oshdev-pdam/oshw-pdambekasi/VisualisasiDesain/VisualisasiWeb4.png

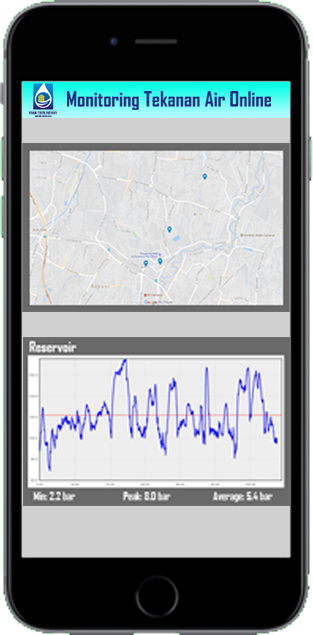
VisualisasiDesain/VisualisasiWeb4.png
