oshdev-pdam/oshw-pdambekasi/VisualisasiDesain/Visualisasi Device 5.png

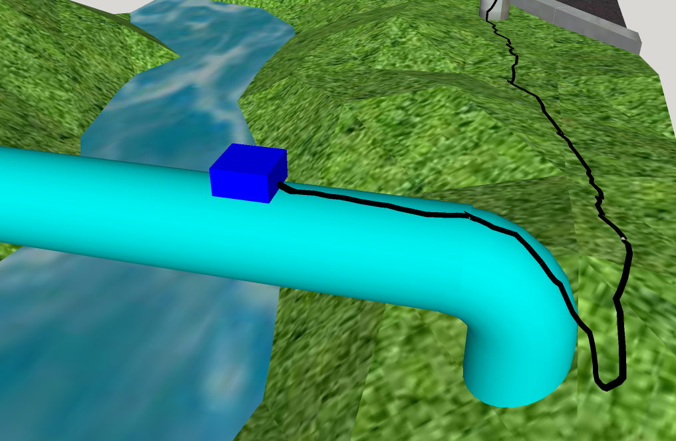
VisualisasiDesain/Visualisasi Device 5.png
