oshdev-pdam/oshw-pdambekasi/README.md

# oshw-pdambekasi

Repositori rintisan untuk OSH Development sensor tekanan air untuk PDAM Kota Bekasi
