oshdev-pdam/oshw-pdambekasi/Data Analysis/Unit One 24 Hours Graph.png

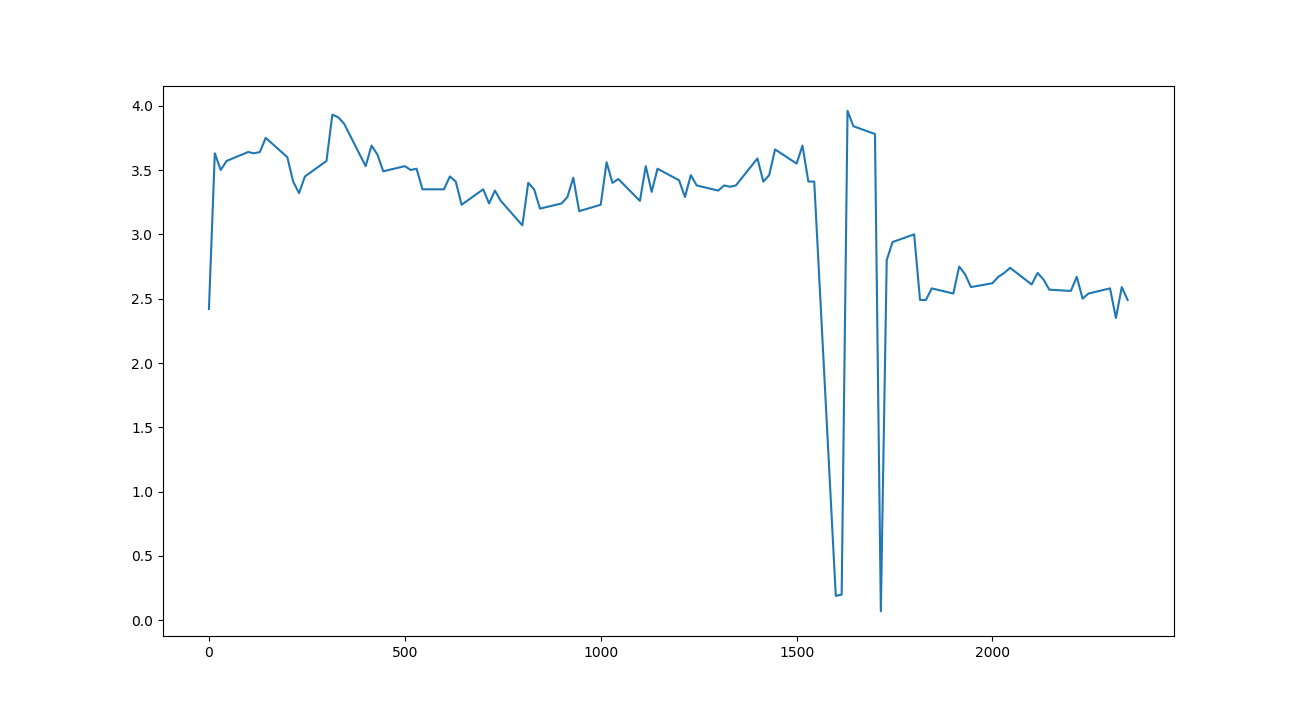
Data Analysis/Unit One 24 Hours Graph.png
