oshdev-pdam/oshw-pdambekasi/Data Analysis/Unit Three 24 Hours Graph.png

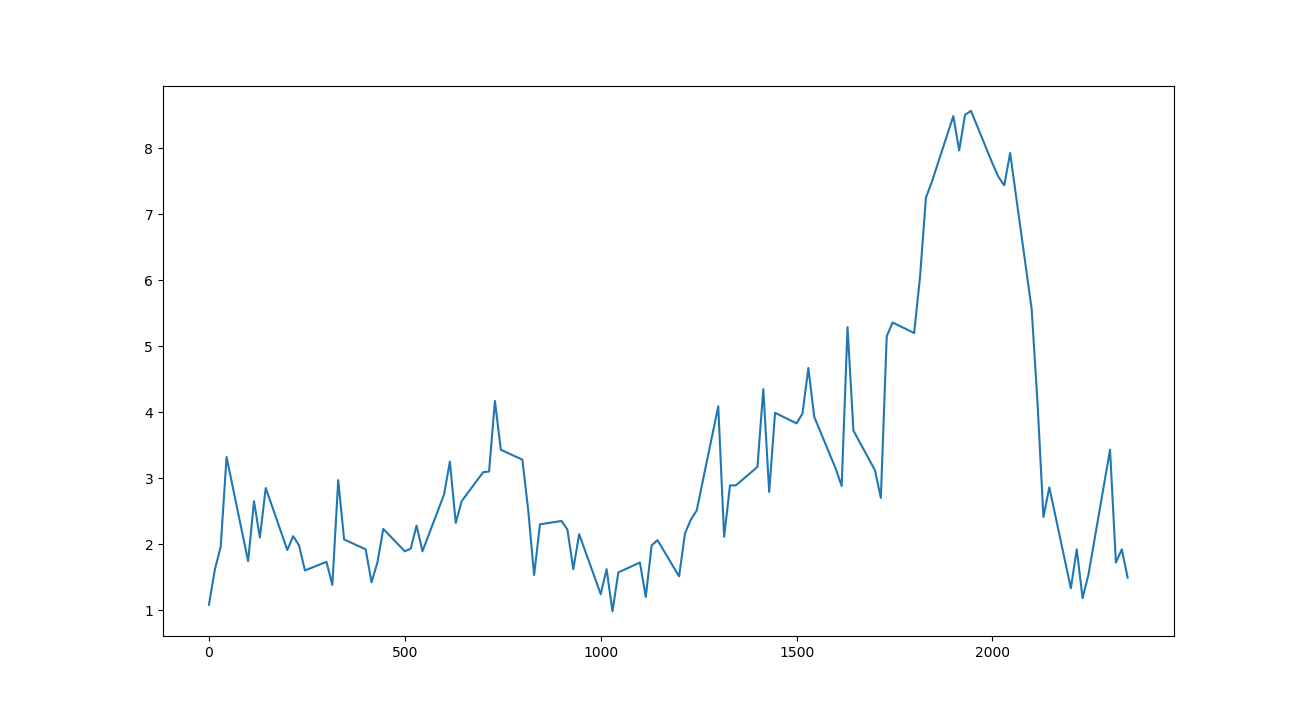
Data Analysis/Unit Three 24 Hours Graph.png
