oshdev-pdam/oshw-pdambekasi/Data Analysis/Unit Two 24 Hours Graph.png

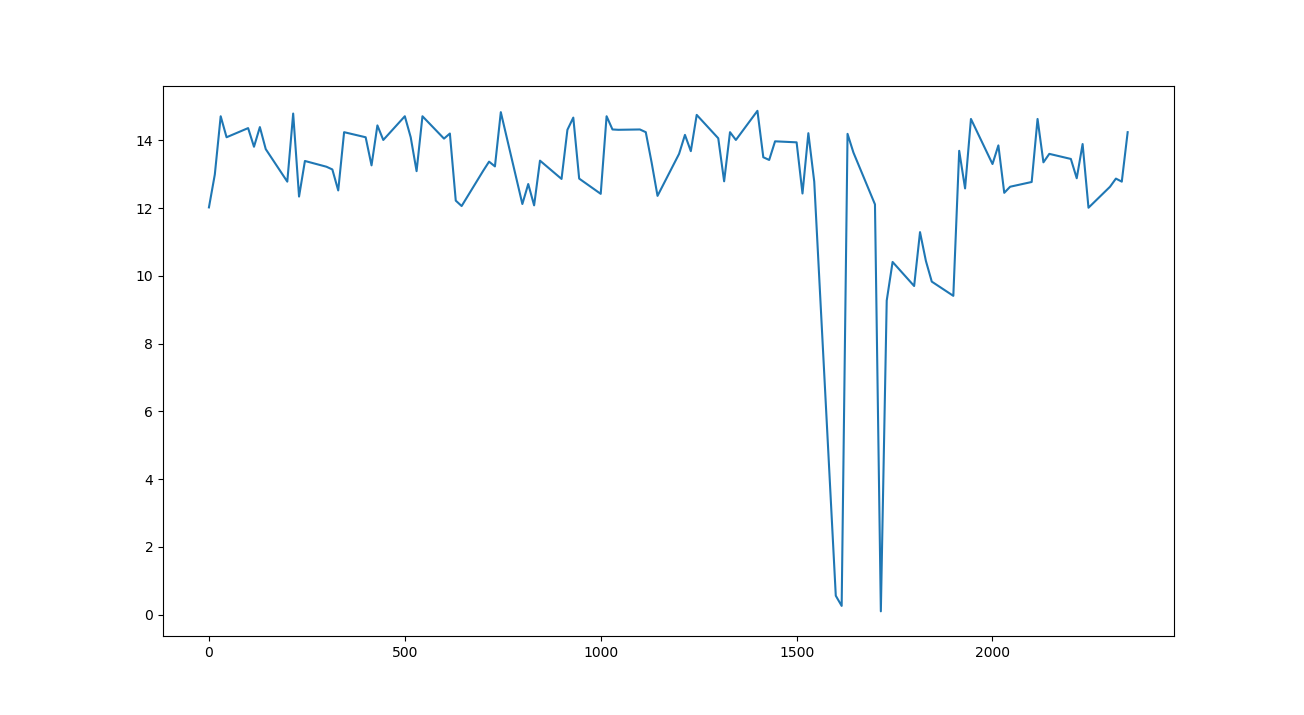
Data Analysis/Unit Two 24 Hours Graph.png
