oshdev-pdam/oshw-pdambekasi/ProductWireframe/ProductUserFlow.jpg

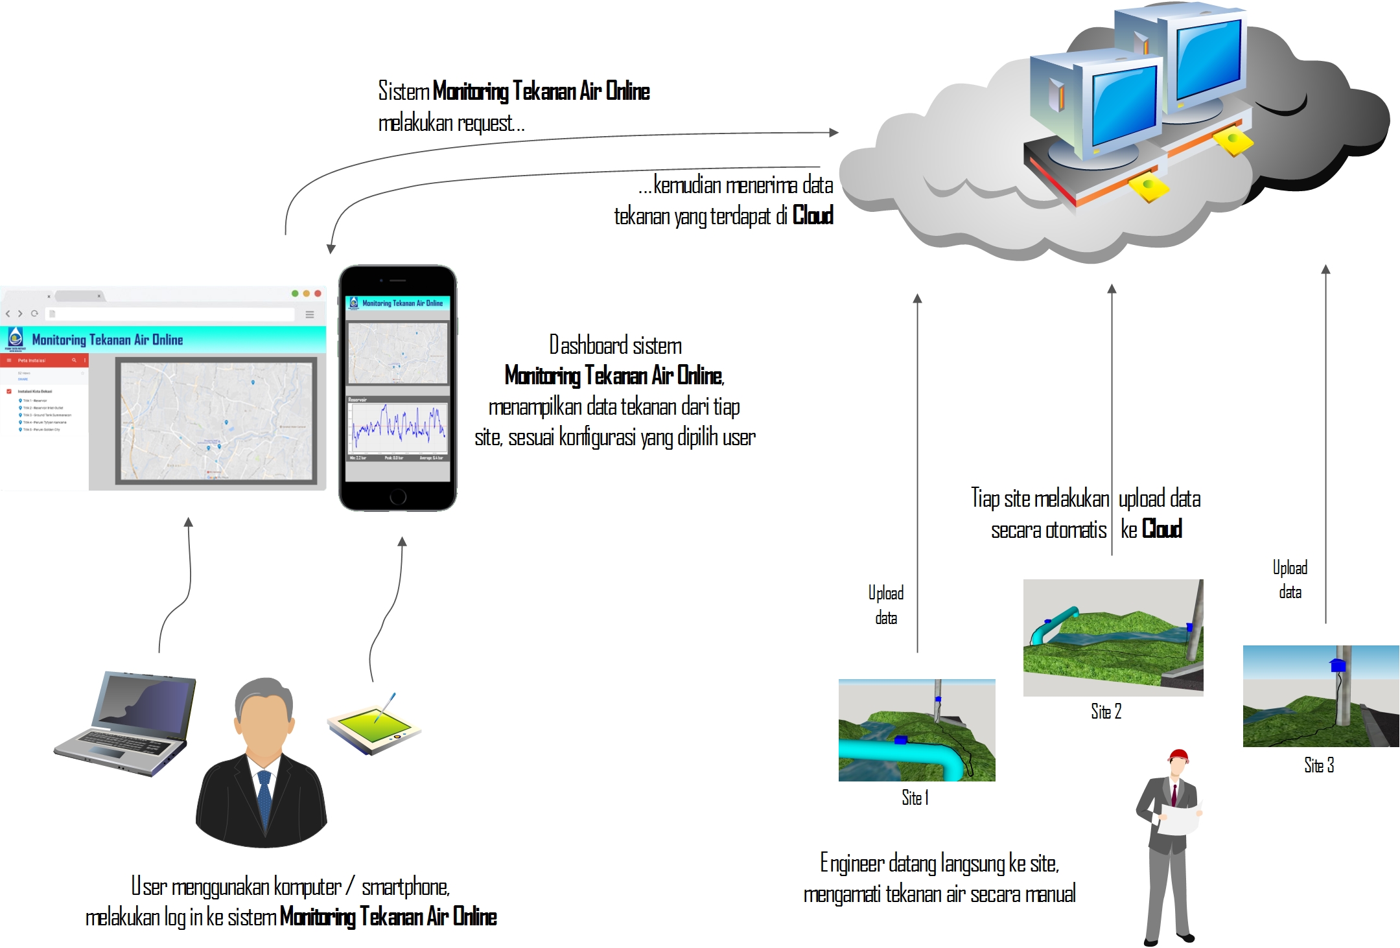
ProductWireframe/ProductUserFlow.jpg
