oshdev-pdam/oshw-pdambekasi/VisualisasiDesain/Visualisasi Device 3.png

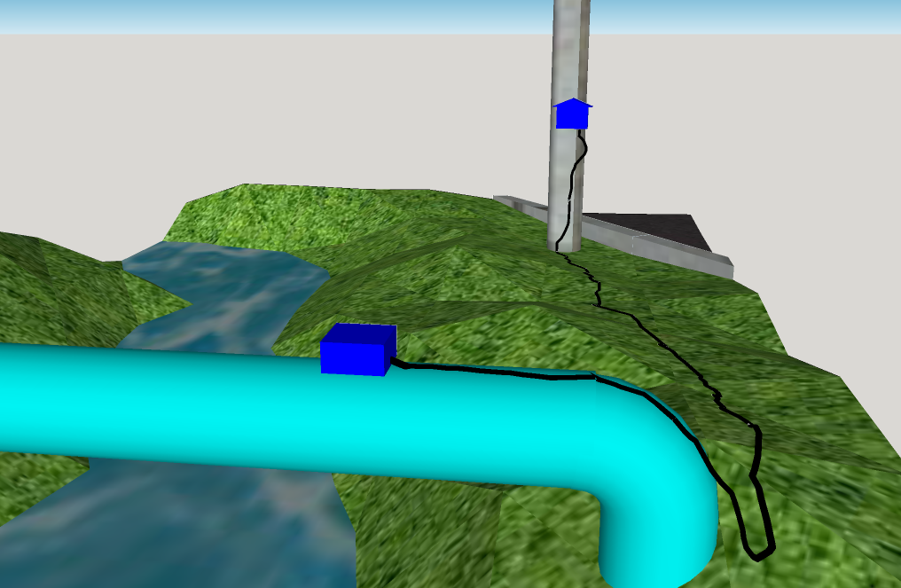
VisualisasiDesain/Visualisasi Device 3.png
