oshdev-pdam/oshw-pdambekasi/Bill Of Maaterial.xlsx

Sheet: Sheet1
 | Bill Of Materials
dapet di: | Nama Komponen BEST | Nama Komponen budget | Justifikasi Pemakaian | Harga Satuan BEST | Harga Satuan budget | Quantity | Harga Total BEST | Harga Total budget
www.tokopedia.com/akhishop/adafruit-feather-m0-adalogger | Adafruit Feather M0 Adalogger |  | Sebagai Master & Slave, plus logging ke kartu MicroSD | Rp 305000.00 | Rp 305000.00 | 1 | Rp 305000.00 | Rp 305000.00
www.tokopedia.com/rajacell/ds3231-i2c-rtc-module-for-arduino-real-time-clock-iic-module | DS3231 I2C RTC Module |  | Modul Real-Time Clock untuk logging dan fungsi wakeup | Rp 24500.00 | Rp 24500.00 | 1 | Rp 24500.00 | Rp 24500.00
www.tokopedia.com/tokoduino/max485-ttl-to-rs485-to-ttl-rs-485-serial-module-converter-arduino | MAX485 TTL to RS485 Module |  | Untuk melakukan transmisi data antara Master dan Slave | Rp 20000.00 | Rp 20000.00 | 2 | Rp 40000.00 | Rp 40000.00
www.tokopedia.com/diggyshop/pressure-transmitter-dc-5v-0-174-psi-12mpa-pressure-sensor | Pressure Transmitter DC 5V 0-1.2MPa (0-10 bar) |  | Sensor tekanan air | Rp 250000.00 | Rp 250000.00 | 1 | Rp 250000.00 | Rp 250000.00
www.tokopedia.com/akhishop/adafruit-fona-808-mini-cellular-gsm-gps-breakout | Adafruit FONA SIM808 |  | Modul GSM dengan performa teruji | Rp 750000.00 |  | 1 | Rp 750000.00
www.tokopedia.com/dielectronics/sim900-sim900a-v40-ver4-v4-module-gsm-gprs-board-with-antena |  | SIM900 GSM Module |  |  | Rp 220000.00 | 1 |  | Rp 220000.00
www.indorcstore.com/id/other-lipo/895-turnigy-3000mah-3s-30c-lipo-pack.html | Turnigy Li-Po 3 Cell 3000mAh |  | Baterai backup saat terjadi pemadaman | Rp 500000.00 |  | 1 | Rp 500000.00
www.indorcstore.com/id/other-lipo/949-turnigy-1000mah-3s-20c-lipo-pack.html |  | Turnigy Li-Po 3 Cell 1000mAh |  |  | Rp 190000.00 | 1 |  | Rp 190000.00
www.tokopedia.com/buayainstrument/turnigy-5a-8-40v-sbec-ubec-for-lipo | Turnigy 5A UBEC SBEC for Li-Po |  | Menurunkan tegangan untuk digunakan Master dan Slave | Rp 115000.00 |  | 2 | Rp 230000.00
www.tokopedia.com/buayainstrument/turnigy-3a-ubec-with-low-voltage-buzzer |  | Turnigy 3A UBEC for Li-Po |  |  | Rp 85000.00 | 2 |  | Rp 170000.00
www.jababekaelektrik.com/collections/electric-enclosure/products/tibox-steel-enclosure-ip-65 | Tibox Steel IP65 250Hx200Wx150D |  | Sebagai casing bagi Master | Rp 306000.00 |  | 1 | Rp 306000.00
www.tokopedia.com/mrdelectronics/junction-box-panel-box-250x200x110mm-ip66 |  | Junction Box IP66 250Hx200Wx110D |  |  | Rp 95000.00 | 1 |  | Rp 95000.00
www.jababekaelektrik.com/collections/electric-enclosure/products/tibox-ip66-abs-enclosure | Tibox IP66 ABS 110Hx80Wx70D |  | Sebagai casing bagi Slave | Rp 49500.00 |  | 1 | Rp 49500.00
www.tokopedia.com/mrdelectronics/junction-box-panel-box-250x200x110mm-ip66 |  | Junction Box IP66 80Hx80Wx40D |  |  | Rp 19000.00 | 1 |  | Rp 19000.00
 | Power switcher module (PLN ke 9V pake adapter [mirip charger HP], tambah rangkaian switcher yang belom ketemu) |  | Memungkinkan penggunaan sumber listrik PLN (utama) dan baterai (cadangan) secara bersamaan | Rp 200000.00 | Rp 200000.00 | 1 | Rp 200000.00 | Rp 200000.00
 | SIM Card dan biaya pulsa modul |  | Untuk transmisi data dari Master ke Server | Rp 100000.00 | Rp 100000.00 | 1 | Rp 100000.00 | Rp 100000.00
 | Komponen lainnya |  | Kabel, sealant, bikin PCB, cable tie, dan lainnya | Rp 200000.00 | Rp 200000.00 | 1 | Rp 200000.00 | Rp 200000.00
 |  |  |  |  | TOTAL |  | Rp 2955000.00 | Rp 1813500.00

Sheet: Budget
 | Nama Komponen DEVICE GSM | Justifikasi Pemakaian | Harga Satuan | Jumlah | Harga Total | Source
lokal | SIM900 GSM Module | Modul GSM dengan performa teruji | Rp 220000.00 | 1 | Rp 220000.00 | https://www.tokopedia.com/dielectronics/sim900-sim900a-v40-ver4-v4-module-gsm-gprs-board-with-antena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
lokal | SIM Card dan biaya pulsa modul | Untuk transmisi data dari Master ke Server | Rp 100000.00 | 1 | Rp 100000.00
adafruit | Adafruit Feather M0 Adalogger | Sebagai Master & Slave, plus logging ke kartu MicroSD | Rp 305000.00 | 1 | Rp 305000.00 | https://www.adafruit.com/product/2796
lokal | DS3231 I2C RTC Module | Modul Real-Time Clock untuk logging dan fungsi wakeup | Rp 24500.00 | 1 | Rp 24500.00 | https://www.tokopedia.com/pitoserba/ds3231-i2c-rtc-module-modul-jam-arduino-raspberry-pi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
lokal | MAX485 TTL to RS485 Module | Untuk melakukan transmisi data antara Master dan Slave | Rp 20000.00 | 2 | Rp 40000.00 | https://www.tokopedia.com/tokoduino/max485-ttl-to-rs485-to-ttl-rs-485-serial-module-converter-arduino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
lokal | Pressure Transmitter DC 5V 0-1.2MPa (0-10 bar) | Sensor tekanan air | Rp 250000.00 | 1 | Rp 250000.00 | https://www.tokopedia.com/diggyshop/pressure-transmitter-dc-5v-0-174-psi-12mpa-pressure-sensor?src=topads
lokal | Turnigy Li-Po 3 Cell 1000mAh | Baterai backup saat terjadi pemadaman | Rp 190000.00 | 1 | Rp 190000.00 | https://www.tokopedia.com/nanomarket/baterai-lipo-turnigy-1000mah-3s-20c-lipo-pack
lokal | Turnigy 3A UBEC for Li-Po | Menurunkan tegangan untuk digunakan Master dan Slave | Rp 85000.00 | 2 | Rp 170000.00 | https://www.tokopedia.com/andreas-ega/ubec-turnigy-3a-5-6v-buzzer
lokal | Junction Box IP66 250Hx200Wx110D | Sebagai casing bagi Master | Rp 95000.00 | 1 | Rp 95000.00 | https://www.tokopedia.com/trijayatehnik/junction-box-uk200x150x100-ip66
lokal | Junction Box IP66 80Hx80Wx40D | Sebagai casing bagi Slave | Rp 19000.00 | 1 | Rp 19000.00 | https://www.tokopedia.com/trijayatehnik/junction-box-uk125x125x75-ip66
lokal | Power switcher module | Memungkinkan penggunaan sumber listrik PLN (utama) dan baterai (cadangan) secara bersamaan | Rp 200000.00 | 1 | Rp 200000.00 | https://www.tokopedia.com/dielectronics/sim900-sim900a-v40-ver4-v4-module-gsm-gprs-board-with-antena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
 | Komponen lainnya | Kabel, sealant, bikin PCB, cable tie, dan lainnya | Rp 200000.00 | 1 | Rp 200000.00
 |  |  | TOTAL |  | Rp 1813500.00
 | Nama Komponen DEVICE LoRa | Justifikasi Pemakaian | Harga Satuan | Jumlah | Harga Total
www.tokopedia.com/raspberrypi/lora-bee-915-mhz-dragino | Dragino LoRa Bee 915MHz | Modul LoRa untuk transmisi data | Rp 250000.00 | 1 | Rp 250000.00 | www.tokopedia.com/raspberrypi/lora-bee-915-mhz-dragino
lokal | Adafruit Feather M0 Adalogger | Sebagai Master & Slave, plus logging ke kartu MicroSD | Rp 305000.00 | 1 | Rp 305000.00 | https://www.adafruit.com/product/2796
lokal | DS3231 I2C RTC Module | Modul Real-Time Clock untuk logging dan fungsi wakeup | Rp 24500.00 | 1 | Rp 24500.00 | https://www.tokopedia.com/pitoserba/ds3231-i2c-rtc-module-modul-jam-arduino-raspberry-pi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
lokal | MAX485 TTL to RS485 Module | Untuk melakukan transmisi data antara Master dan Slave | Rp 20000.00 | 2 | Rp 40000.00 | https://www.tokopedia.com/tokoduino/max485-ttl-to-rs485-to-ttl-rs-485-serial-module-converter-arduino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
lokal | Pressure Transmitter DC 5V 0-1.2MPa (0-10 bar) | Sensor tekanan air | Rp 250000.00 | 1 | Rp 250000.00 | https://www.tokopedia.com/diggyshop/pressure-transmitter-dc-5v-0-174-psi-12mpa-pressure-sensor?src=topads
lokal | Turnigy Li-Po 3 Cell 1000mAh | Baterai backup saat terjadi pemadaman | Rp 190000.00 | 1 | Rp 190000.00 | https://www.tokopedia.com/nanomarket/baterai-lipo-turnigy-1000mah-3s-20c-lipo-pack
lokal | Turnigy 3A UBEC for Li-Po | Menurunkan tegangan untuk digunakan Master dan Slave | Rp 85000.00 | 2 | Rp 170000.00 | https://www.tokopedia.com/andreas-ega/ubec-turnigy-3a-5-6v-buzzer
lokal | Junction Box IP66 250Hx200Wx110D | Sebagai casing bagi Master | Rp 95000.00 | 1 | Rp 95000.00 | https://www.tokopedia.com/trijayatehnik/junction-box-uk200x150x100-ip66
lokal | Junction Box IP66 80Hx80Wx40D | Sebagai casing bagi Slave | Rp 19000.00 | 1 | Rp 19000.00 | https://www.tokopedia.com/trijayatehnik/junction-box-uk125x125x75-ip66
lokal | Power switcher module | Memungkinkan penggunaan sumber listrik PLN (utama) dan baterai (cadangan) secara bersamaan | Rp 200000.00 | 1 | Rp 200000.00 | https://www.tokopedia.com/dielectronics/sim900-sim900a-v40-ver4-v4-module-gsm-gprs-board-with-antena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
lokal | Komponen lainnya | Kabel, sealant, bikin PCB, cable tie, dan lainnya | Rp 200000.00 | 1 | Rp 200000.00
 |  |  | TOTAL |  | Rp 1743500.00
