oshdev-pdam/oshw-pdambekasi/BOM Completion - Unit #1.xlsx

LIST BELANJA UNIT #1
Nama Komponen | Harga Satuan | Jumlah | Harga Total | Website Vendor | Link Belanja | Confirmed Tersedia
SIM900 GSM Module | Rp 220000 | 1 | Rp 220000 | Toped | http://bit.ly/2xSdEz1
SIM Card dan biaya pulsa modul | Rp 100000 | 1 | Rp 100000 | Lokal
Adafruit Feather M0 Adalogger | Rp 305000 | 1 | Rp 305000 | Bukalapak | http://bit.ly/2yTtBFa
DS3231 I2C RTC Module | Rp 24500 | 1 | Rp 24500 | Toped | http://bit.ly/2l1Ddrs
MAX485 TTL to RS485 Module | Rp 20000 | 2 | Rp 40000 | Toped | http://bit.ly/2inzYtu
Pressure Transmitter DC 5V 0-1.2MPa (0-10 bar) | Rp 250000 | 1 | Rp 250000 | Toped | http://bit.ly/2ytzSqx
Turnigy Li-Po 3 Cell 1000mAh | Rp 190000 | 1 | Rp 190000 | Toped | http://bit.ly/2gnOyNi
Turnigy 3A UBEC for Li-Po | Rp 85000 | 2 | Rp 170000 | Toped | http://bit.ly/2ionUIg
Junction Box IP66 250Hx200Wx110D | Rp 95000 | 1 | Rp 95000 | Toped | http://bit.ly/2guRLOD
Junction Box IP66 80Hx80Wx40D | Rp 19000 | 1 | Rp 19000 | Toped | http://bit.ly/2xSxSbZ
Power switcher module | Rp 200000 | 1 | Rp 200000 | Toped | http://bit.ly/2xSdEz1
Komponen lainnya | Rp 200000 | 1 | Rp 200000 | Glodok
 | TOTAL |  | Rp 1813500
Ready Stock
Ready Sebagian
Tidak Ready/Inden/Harus Import
