oshdev-pdam/oshw-pdambekasi/KiCAD/Latest/OSH DEV-SchDoc.pdf

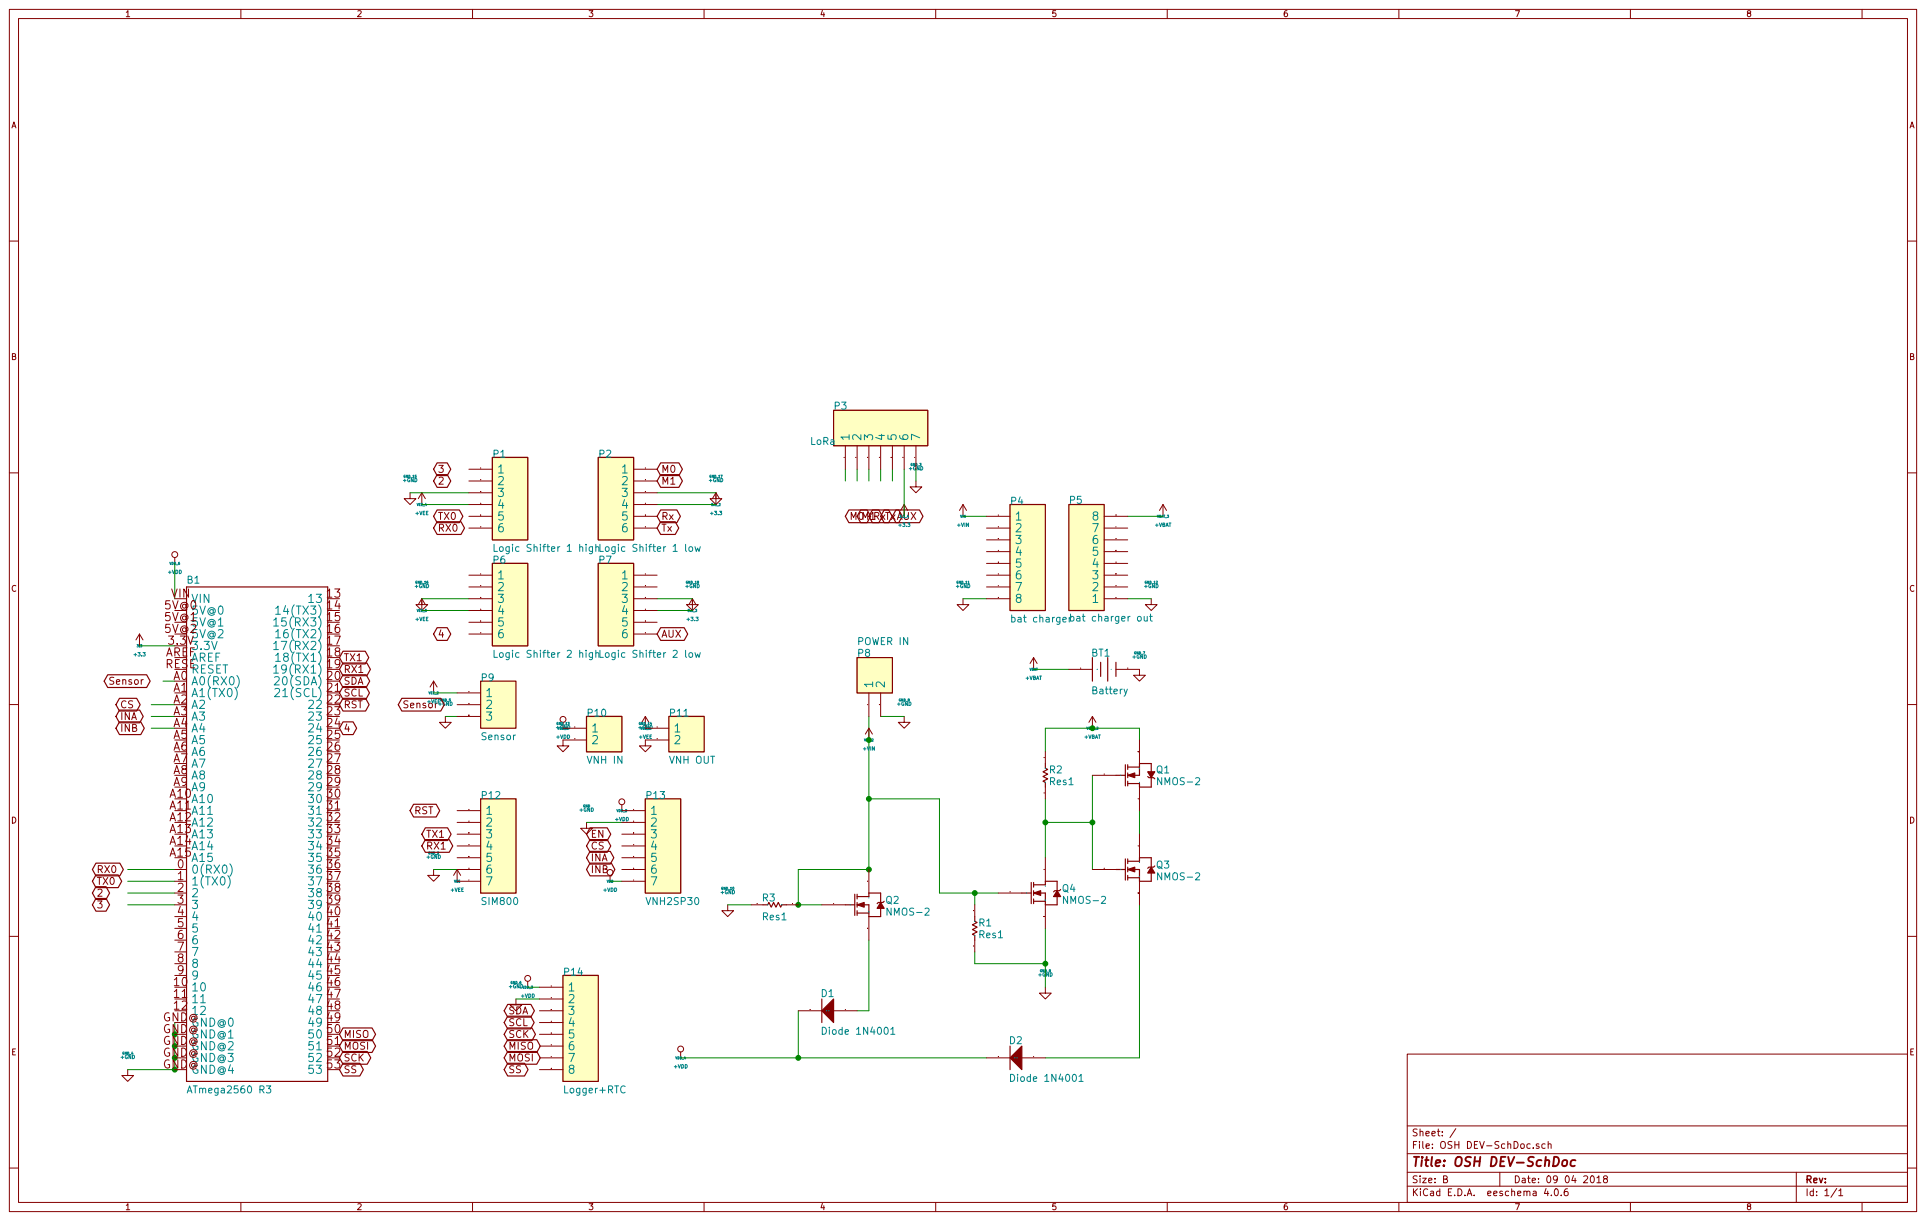
[picture p23: page 1]

VDD_2 +VDD
File: OSH DEV-SchDoc.sch Sheet: / EN
INA
INB

Id: 1/1 Title: OSH DEV-SchDoc
