oshdev-pdam/oshw-pdambekasi/(list of files, drawings)

Other design files:
OSH DEV.PcbDoc
