oshdev-pdam/oshw-pdambekasi/KiCAD/Project 1.kicad_pcb

## KiCad design KiCAD/Project 1.kicad_pcb (2017-10-31)

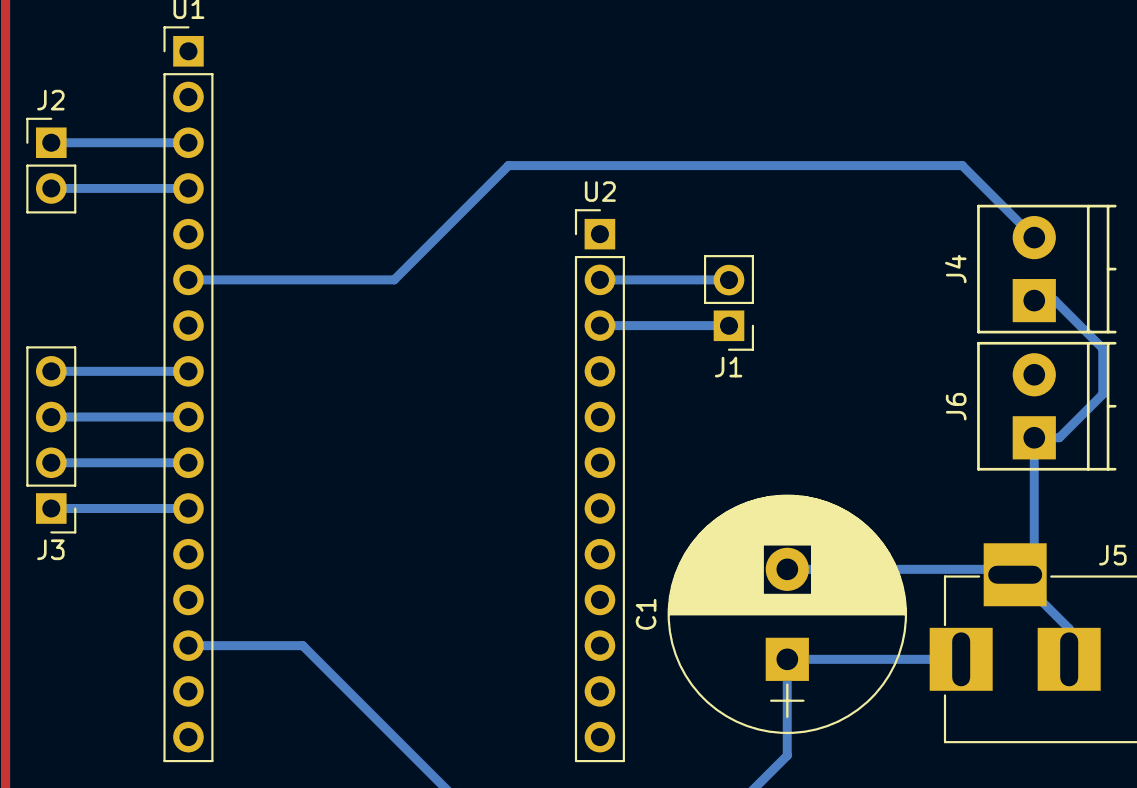
[picture p24: board Project 1.kicad_pcb from above]

Board: 2 copper layers, 9 parts (0 on the bottom side), 11 nets.

Parts:
C1: CAP_POL; CP_Radial_D13.0mm_P5.00mm
J1: SIM900; Pin_Header_Straight_1x02_Pitch2.54mm
J2: RTC; Pin_Header_Straight_1x02_Pitch2.54mm
J3: Micro Pro; Pin_Header_Straight_1x04_Pitch2.54mm
J4: solid state controller; TerminalBlock_Phoenix_PT-3.5mm_2pol
J5: Jack-DC; BARREL_JACK
J6: Battery; TerminalBlock_Phoenix_PT-3.5mm_2pol
U1: ADAFRUIT_FEATHER; Pin_Header_Straight_1x16_Pitch2.54mm
U2: ADAFRUIT_FEATHER; Pin_Header_Straight_1x12_Pitch2.54mm

Connections:
DE: J3.2, U1.10
DI: J3.1, U1.11
GND: C1.2, J4.1, J5.2, J5.3, J6.1
RE: J3.3, U1.9
RO: J3.4, U1.8
RX: J1.2, U2.2
SCL: J2.2, U1.4
SDA: J2.1, U1.3
SS: J4.2, U1.6
TX: J1.1, U2.3
VCC: C1.1, J5.1, U1.14
