oshdev-pdam/oshw-pdambekasi/KiCAD/Latest/OSH DEV-PcbDoc.kicad_pcb

## KiCad design KiCAD/Latest/OSH DEV-PcbDoc.kicad_pcb (2018-04-09)

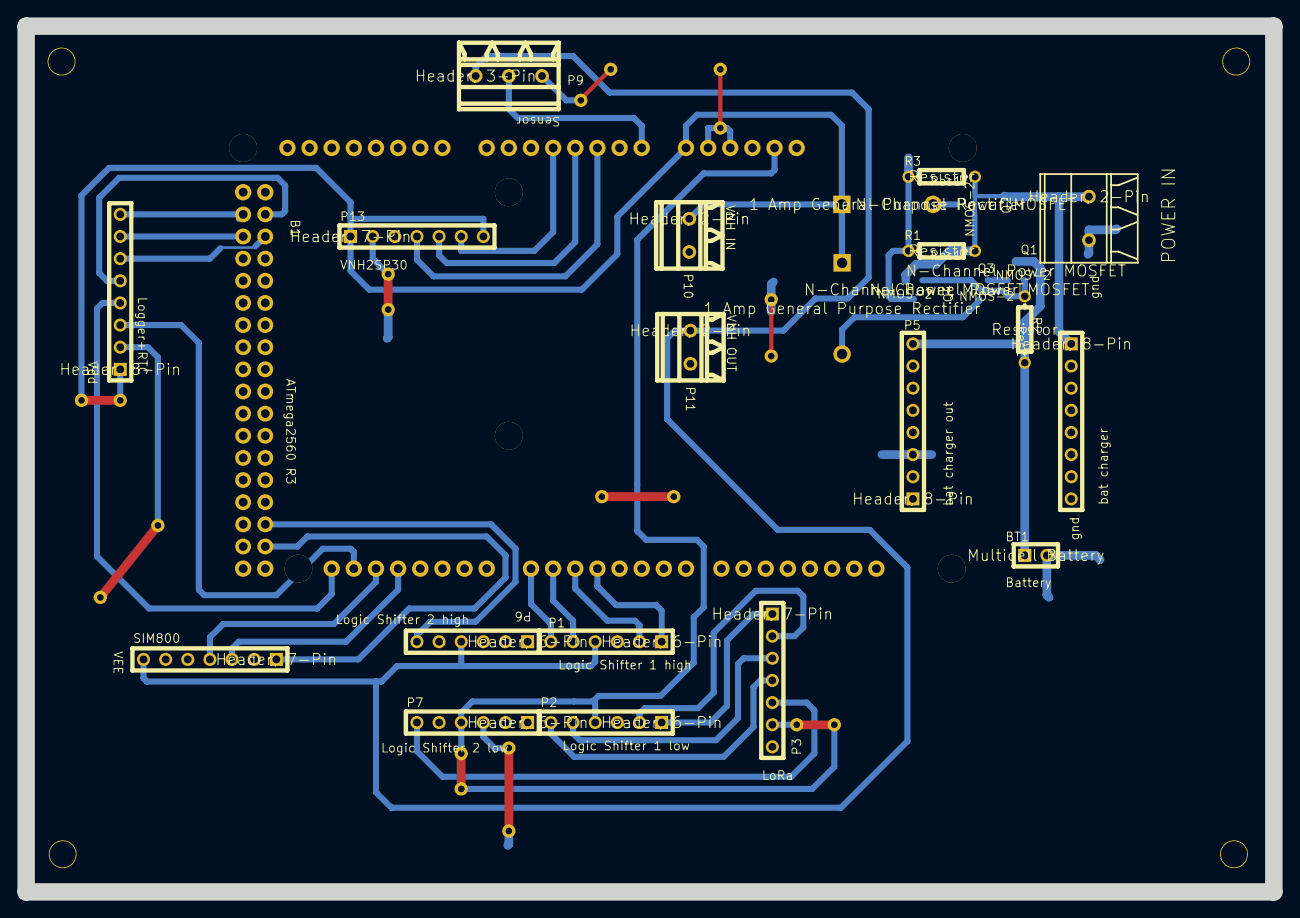
[picture p25: board OSH DEV-PcbDoc.kicad_pcb from above]

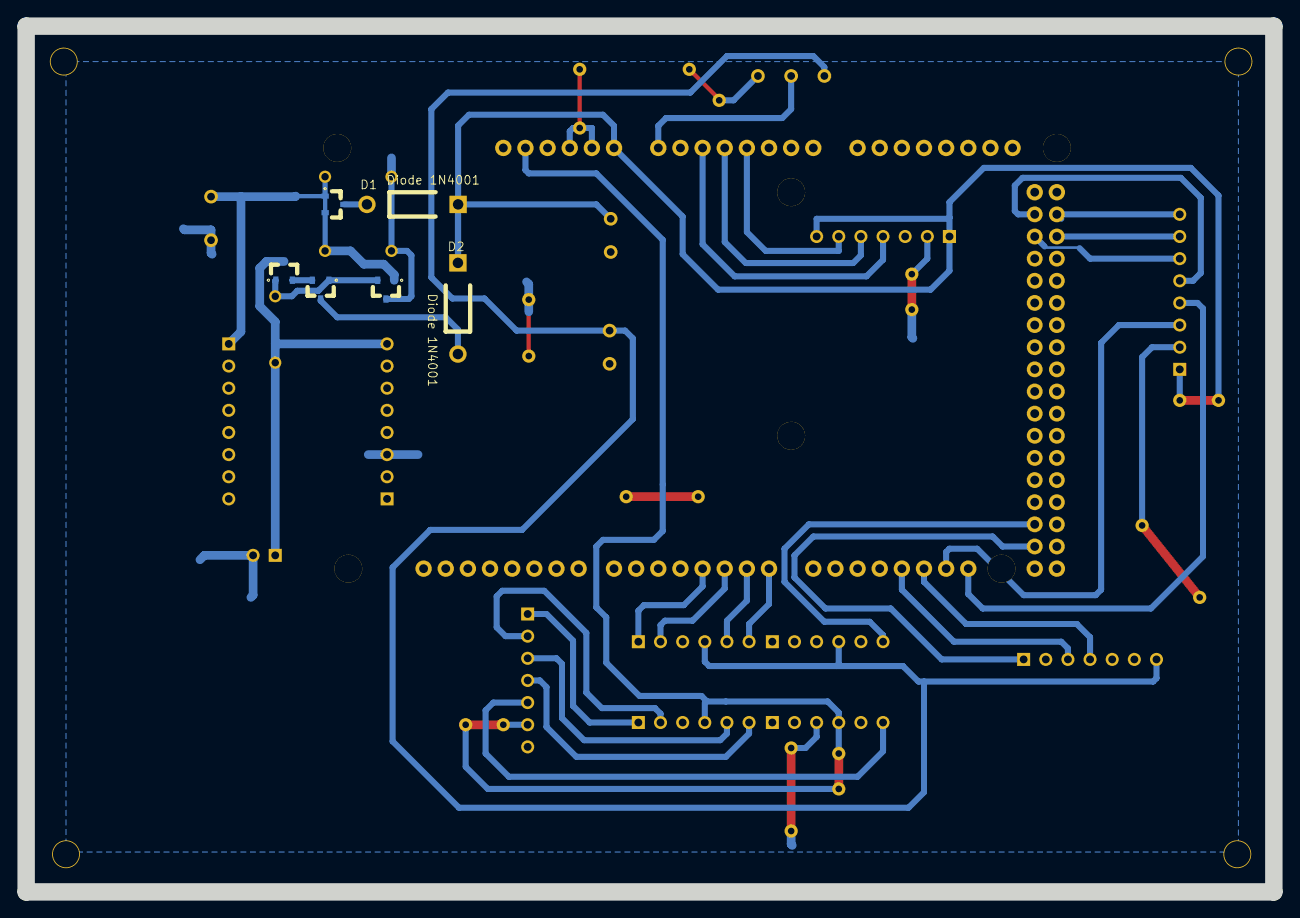
[picture p26: board OSH DEV-PcbDoc.kicad_pcb from below]

Board: 2 copper layers, 143.1 x 99.3 mm, 25 parts (6 on the bottom side), 33 nets.

Parts:
B1: ARDUINO_MEGA
BT1: Multicell Battery; BAT-2
D1, D2: 1 Amp General Purpose Rectifier; DO-41
P1, P2, P6, P7: Header, 6-Pin; HDR1X6
P3, P12, P13: Header, 7-Pin; HDR1X7
P4, P5, P14: Header, 8-Pin; HDR1X8
P8: Header, 2-Pin; MKDS3_2RMM
P9: Header, 3-Pin; MKDS1_3R3_8
P10, P11: Header, 2-Pin; MKDS1_2R3_8
Q1, Q2, Q3, Q4: N-Channel Power MOSFET; SOT-23B_L
R1, R2, R3: Resistor; AXIAL-0.3

Connections:
3.3: B1.3.3V, P2.4, P3.6, P7.4
GND: B1.GND@, BT1.2, P1.3, P2.3, P3.7, P4.6, P4.7, P4.8, P5.1, P5.2, P5.3, P6.3, P7.3, P8.2, P9.3, P10.2, P11.2, P12.6, P13.2, P14.2, Q4.3, R1.1, R3.1
NetB1_0: B1.0, P1.6
NetB1_1: B1.1, P1.5
NetB1_2: B1.2, P1.2
NetB1_3: B1.3, P1.1
NetB1_18: B1.18, P12.3
NetB1_19: B1.19, P12.4
NetB1_20: B1.20, P14.3
NetB1_21: B1.21, P14.4
NetB1_22: B1.22, P12.1
NetB1_24: B1.24, P6.6
NetB1_50: B1.50, P14.6
NetB1_51: B1.51, P14.7
NetB1_52: B1.52, P14.5
NetB1_53: B1.53, P14.8
NetB1_A0: B1.A0, P9.2
NetB1_A2: B1.A2, P13.4
NetB1_A3: B1.A3, P13.5
NetB1_A4: B1.A4, P13.6
NetD1_1: D1.1, Q2.3
NetD2_1: D2.1, Q3.3
NetP2_1: P2.1, P3.1
NetP2_2: P2.2, P3.2
NetP2_5: P2.5, P3.3
NetP2_6: P2.6, P3.4
NetP3_5: P3.5, P7.6
NetQ1_1: Q1.1, Q3.1, Q4.2, R2.1
NetQ1_2: Q1.2, Q3.2
VBAT: BT1.1, P5.8, Q1.3, R2.2
VDD: B1.VIN, D1.2, D2.2, P10.1, P13.1, P13.7, P14.1
VEE: P1.4, P6.4, P9.1, P11.1, P12.7
VIN: P4.1, P8.1, Q2.1, Q2.2, Q4.1, R1.2, R3.2
