oshdev-pdam/oshw-pdambekasi/(commit log)

2017-10-17 Product Wireframe
    Representasi visual dari alur kerja alat, ditampilkan dalam dokumentasi secara deskriptif dan dengan bantuan berupa bagan
2017-10-19 Bill Of Material
    anggaran perbelanjaan dan link toko pembelian
    [Bill Of Maaterial.xlsx]
2017-10-19 Add BOM Completion for Unit 1
    [BOM Completion - Unit #1.xlsx]
2017-10-20 KiCAD files eeschema and pcb
2017-10-20 KiCAD
    KiCAD file seluruh design skematik (Eeschema) dan PCB
2017-10-20 KiCAD Files
    Eeschema dan PCB file electrical design
    [Skematik master 1.sch]
2017-10-30 KiCAD Files
    KiCAD files lengkap untuk design ver.1
    [Project 1 - Copy.sch, Project 1.kicad_pcb, Project 1.sch, Skematik master 1.sch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]
2017-10-31 Basic Function Codes
    Master: Adafruit Feather M0
    Slave: Arduino Micro
2018-04-09 Latest PCB Design
    [OSH DEV-PcbDoc.kicad_pcb]
2018-04-11 Latest Schematics
    [OSH DEV-SchDoc.sch]
2018-04-12 Schematics PDF
2018-04-24 Data Gathering & Analysis
    Ambil data bulan Maret-April untuk unit 1, 2, 3. Program untuk mengkonversi data .json ke .csv (dan grafik penggunaan 24 jam) ada di file Data_Gathering.py
    [Unit One March-April Data.csv, Unit Three March-April Data.csv, Unit Two March-April Data.csv]
2018-08-31 PCB file Altium
    PCB file ini lebih umum digunakan untuk percetakan di rumah pembuatan PCB lokal. dengan mengirimkan file ini langsung ke rumah pembuatan PCB tidak sesulit mereka untuk memproses file PCB dari KiCAD
    [OSH DEV.PcbDoc]
